MeetDeore19/soc_estimator/calce_plots/calce_A1-008_ocv.png

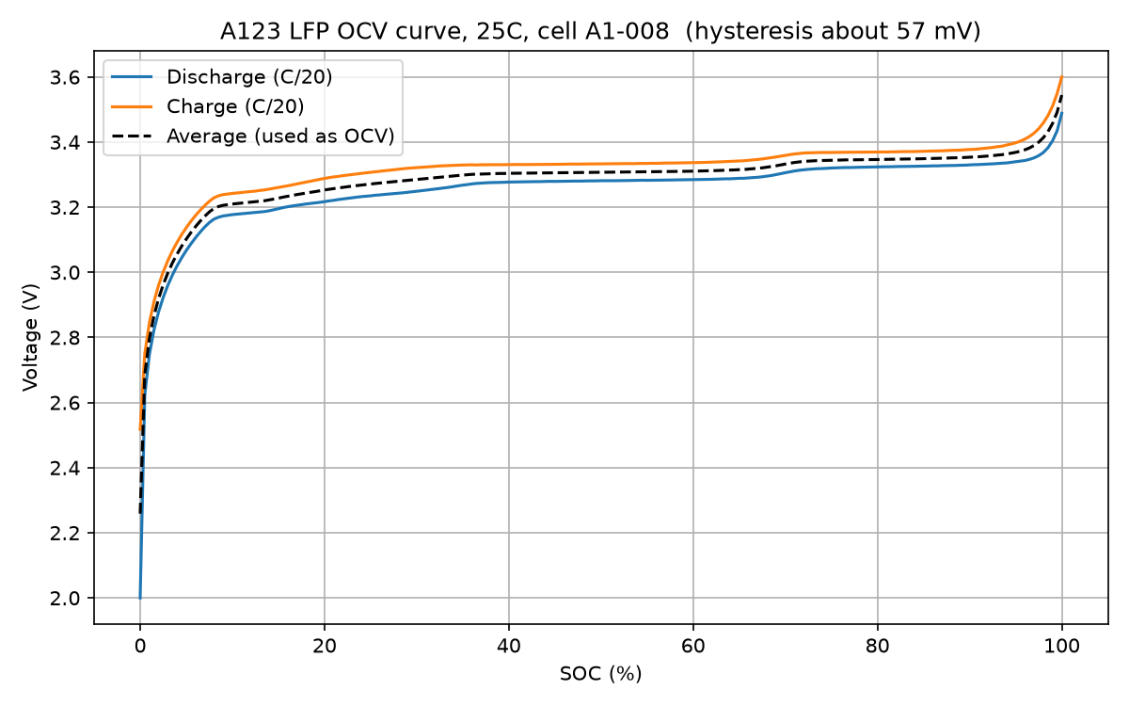
calce_plots/calce_A1-008_ocv.png
