MeetDeore19/soc_estimator/data/20261102_163730_validation_v2.csv

pc_time | esp_ms | c1_v | c2_v | c3_v | c4_v | pack_v | current_a | temp1_c | temp2_c | counted_ah
2026-11-02T16:37:31 | 5591512 | 3.4388 | 3.3575 | 3.4020 | 3.5523 | 13.7506 | 0.0021 | -30.82 | -27.12 | 0.000000
2026-11-02T16:37:32 | 5592512 | 3.4373 | 3.3581 | 3.4022 | 3.5513 | 13.7489 | -0.0026 | -29.41 | -24.45 | -0.000001
2026-11-02T16:37:33 | 5593512 | 3.4389 | 3.3589 | 3.4001 | 3.5525 | 13.7504 | -0.0019 | -28.74 | -24.00 | -0.000001
2026-11-02T16:37:34 | 5594512 | 3.4373 | 3.3603 | 3.4003 | 3.5518 | 13.7497 | -0.0003 | -29.31 | -21.28 | -0.000001
2026-11-02T16:37:35 | 5595512 | 3.4379 | 3.3585 | 3.4016 | 3.5526 | 13.7506 | -0.0016 | -30.00 | -23.27 | -0.000002
2026-11-02T16:37:36 | 5596512 | 3.4392 | 3.3606 | 3.3980 | 3.5540 | 13.7518 | -0.0047 | -30.30 | -23.27 | -0.000003
2026-11-02T16:37:37 | 5597512 | 3.4396 | 3.3591 | 3.4001 | 3.5570 | 13.7558 | -0.0074 | -33.51 | -25.78 | -0.000005
2026-11-02T16:37:38 | 5598512 | 3.4374 | 3.3595 | 3.4012 | 3.5528 | 13.7509 | -0.0016 | -34.00 | -25.78 | -0.000006
2026-11-02T16:37:39 | 5599512 | 3.4378 | 3.3583 | 3.4010 | 3.5543 | 13.7514 | 0.0036 | -34.00 | -24.30 | -0.000005
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
