MeetDeore19/soc_estimator/data/20261102_163730_validation_v2_soc.csv

pc_time | esp_ms | c1_v | c2_v | c3_v | c4_v | pack_v | current_a | temp1_c | temp2_c | counted_ah | t | avg_cell | soc_ekf | soc_sigma | v_pred | offset_learned | soc_gain | soc_coulomb_only | soc_reference
2026-11-02T16:37:31 | 5591512 | 3.4388 | 3.3575 | 3.402 | 3.5523 | 13.7506 | 0.0021 | -30.82 | -27.12 | 0.0 | 0.0 | 3.4376499999999997 | 1.0 | 0.017440836210075736 | 3.37996514 | 0.0 | 2.7859140618934735 | 1.0 | 1.0
2026-11-02T16:37:32 | 5592512 | 3.4373 | 3.3581 | 3.4022 | 3.5513 | 13.7489 | -0.0026 | -29.41 | -24.45 | -1e-06 | 1.0 | 3.4372249999999998 | 1.0 | 0.01273619759030887 | 3.3801336282655576 | 0.0 | 1.414485386659199 | 0.9999999041547545 | 0.9999997717970345
2026-11-02T16:37:33 | 5593512 | 3.4389 | 3.3589 | 3.4001 | 3.5525 | 13.7504 | -0.0019 | -28.74 | -24.0 | -1e-06 | 2.0 | 3.4376 | 1.0 | 0.010668366091758296 | 3.3801450447141965 | 0.0 | 0.9490833186706709 | 1.0 | 0.9999996348752551
2026-11-02T16:37:34 | 5594512 | 3.4373 | 3.3603 | 3.4003 | 3.5518 | 13.7497 | -0.0003 | -29.31 | -21.28 | -1e-06 | 3.0 | 3.437425 | 1.0 | 0.009451613462216353 | 3.3801066930032295 | 0.0 | 0.7151424545967794 | 1.0 | 0.9999994454667938
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
