MeetDeore19/soc_estimator/data/experiments/20261021_171919_zero_offset.csv

pc_time | esp_ms | c1_v | c2_v | c3_v | c4_v | pack_v | current_a | temp1_c | temp2_c | counted_ah
2026-10-21T17:19:19 | 621080 | 3.2896 | 3.2803 | 3.2881 | 3.2912 | 13.1492 | -0.0283 | 24.24 | 12.35 | 0.000000
2026-10-21T17:19:20 | 622080 | 3.2896 | 3.2867 | 3.2818 | 3.2912 | 13.1493 | -0.0114 | 24.29 | 11.88 | -0.000003
2026-10-21T17:19:21 | 623080 | 3.2896 | 3.2867 | 3.2818 | 3.3037 | 13.1618 | -0.0121 | 24.29 | 11.42 | -0.000007
2026-10-21T17:19:22 | 624080 | 3.2772 | 3.2928 | 3.2881 | 3.2912 | 13.1493 | -0.0223 | 24.29 | 12.59 | -0.000013
2026-10-21T17:19:23 | 625080 | 3.2896 | 3.2803 | 3.2881 | 3.3037 | 13.1617 | -0.0119 | 24.29 | 13.35 | -0.000016
2026-10-21T17:19:24 | 626080 | 3.2896 | 3.2867 | 3.2818 | 3.2912 | 13.1493 | -0.0173 | 24.29 | 14.29 | -0.000021
2026-10-21T17:19:25 | 627080 | 3.3021 | 3.2742 | 3.2818 | 3.2912 | 13.1493 | -0.0251 | 24.29 | 14.13 | -0.000028
