MeetDeore19/soc_estimator/data/experiments/20261021_171931_zero_offset.csv

pc_time | esp_ms | c1_v | c2_v | c3_v | c4_v | pack_v | current_a | temp1_c | temp2_c | counted_ah
2026-10-21T17:19:31 | 633080 | 3.3021 | 3.2742 | 3.2818 | 3.3037 | 13.1618 | -0.0060 | 24.29 | 8.47 | 0.000000
2026-10-21T17:19:32 | 634080 | 3.3021 | 3.2742 | 3.2818 | 3.3037 | 13.1618 | -0.0165 | 24.29 | 8.44 | -0.000005
2026-10-21T17:19:33 | 635080 | 3.3021 | 3.2742 | 3.2880 | 3.2976 | 13.1619 | -0.0165 | 24.29 | 9.57 | -0.000009
2026-10-21T17:19:34 | 636080 | 3.3021 | 3.2742 | 3.2818 | 3.2912 | 13.1493 | -0.0362 | 24.29 | 8.58 | -0.000019
2026-10-21T17:19:35 | 637080 | 3.3021 | 3.2742 | 3.2818 | 3.2849 | 13.1430 | -0.0154 | 24.29 | 8.78 | -0.000024
2026-10-21T17:19:36 | 638080 | 3.3021 | 3.2742 | 3.2818 | 3.3037 | 13.1618 | -0.0139 | 24.29 | 7.65 | -0.000027
2026-10-21T17:19:37 | 639080 | 3.2896 | 3.2867 | 3.2818 | 3.2912 | 13.1493 | -0.0199 | 24.29 | 14.78 | -0.000033
2026-10-21T17:19:38 | 640080 | 3.2896 | 3.2867 | 3.2818 | 3.2912 | 13.1493 | -0.0205 | 24.29 | 15.32 | -0.000039
2026-10-21T17:19:39 | 641080 | 3.3021 | 3.2742 | 3.2818 | 3.3037 | 13.1618 | -0.0166 | 24.29 | 15.15 | -0.000043
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
