MeetDeore19/soc_estimator/data/20261102_163730_validation_v2_soc_plot.png

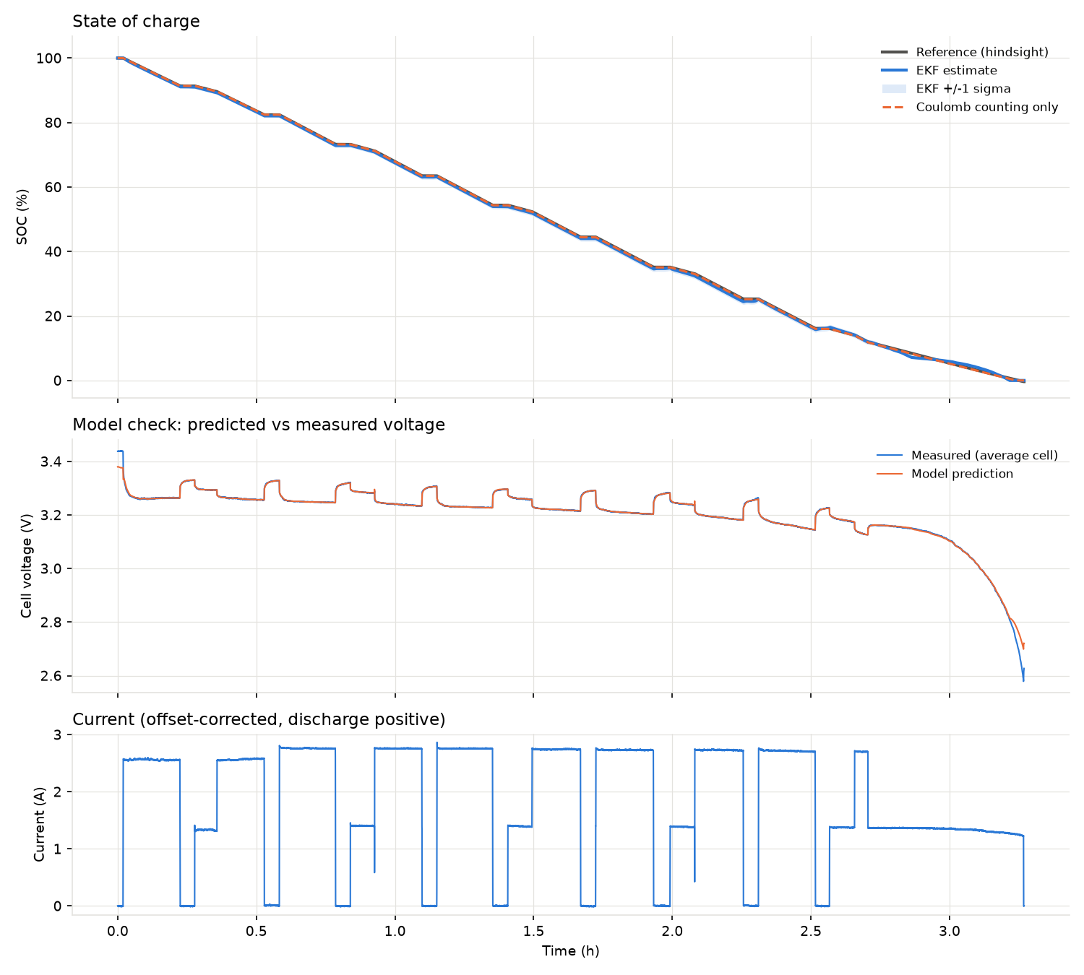
data/20261102_163730_validation_v2_soc_plot.png
