MeetDeore19/soc_estimator/data/experiments/noise_tests/noise_test_caps_soc_plot.png

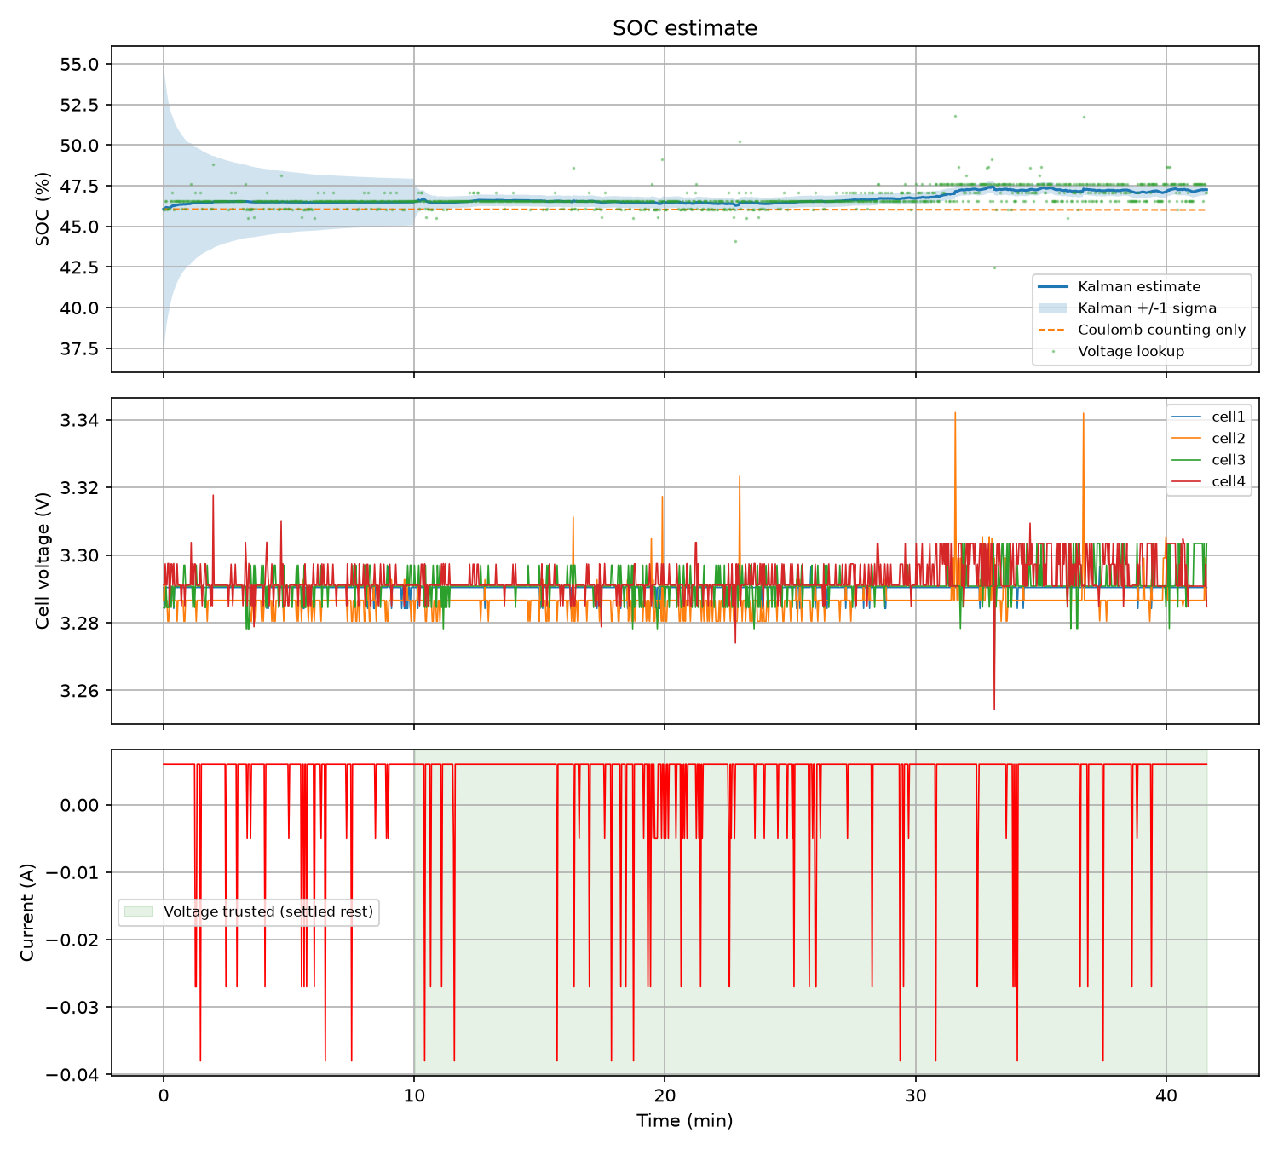
data/experiments/noise_tests/noise_test_caps_soc_plot.png
