MeetDeore19/soc_estimator/data/experiments/noise_tests/noise_test_lowpower_plot.png

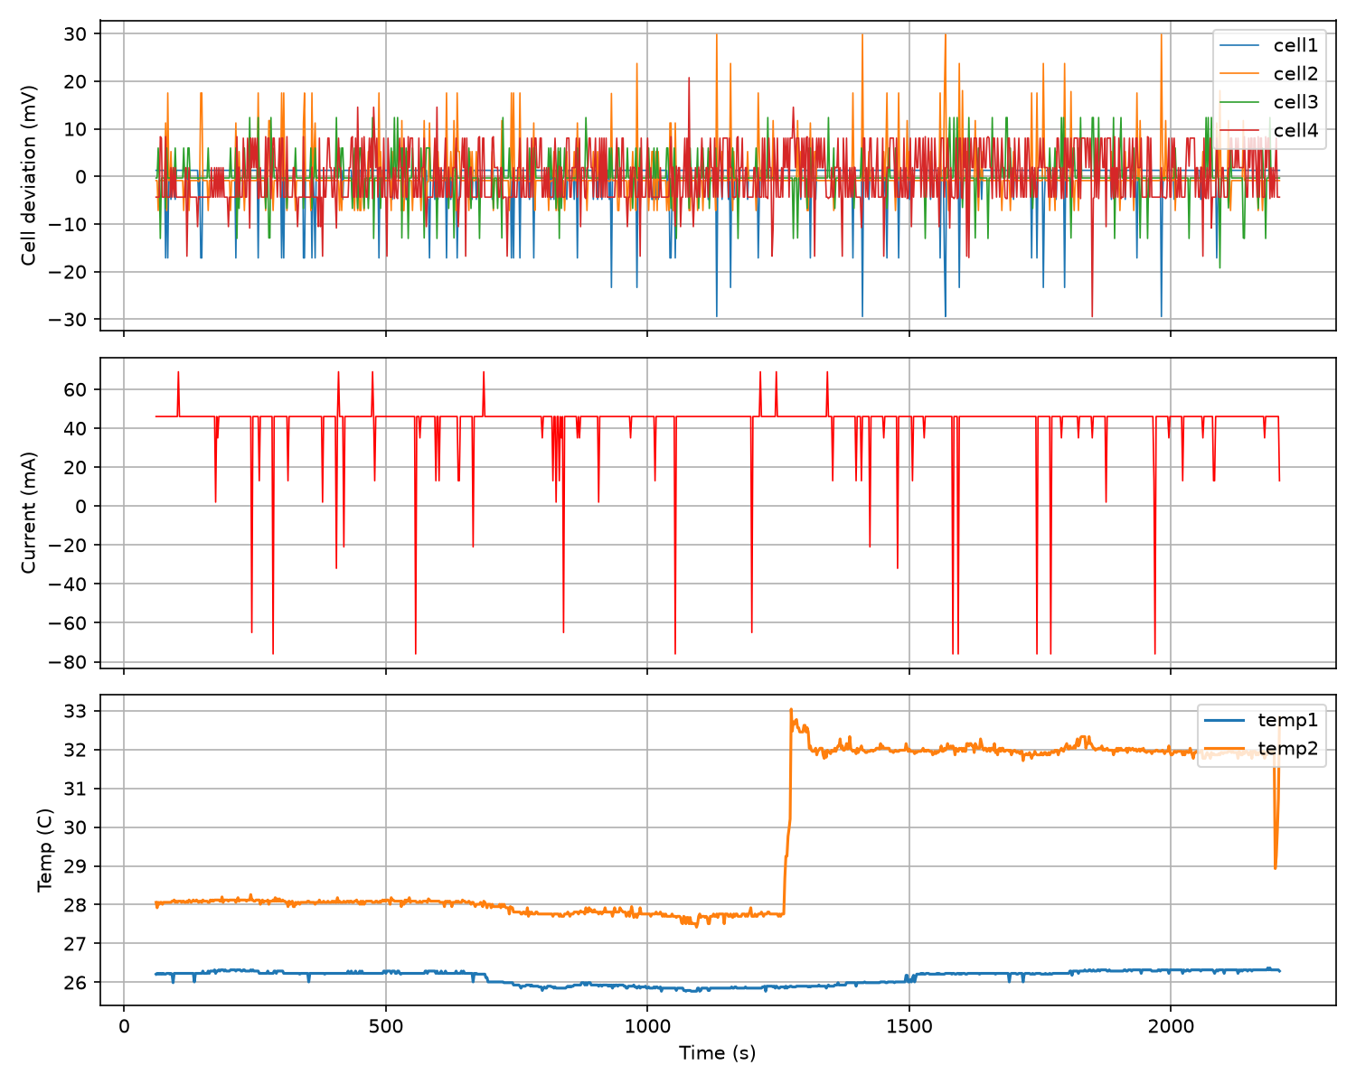
data/experiments/noise_tests/noise_test_lowpower_plot.png
