MeetDeore19/soc_estimator/results/pulse_test_overview.png

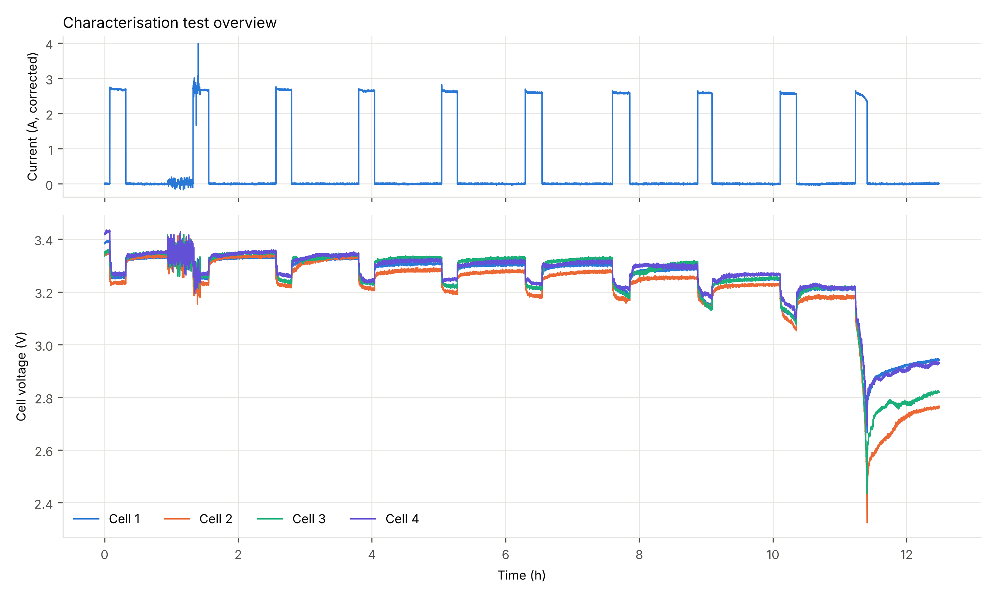
results/pulse_test_overview.png
