MeetDeore19/soc_estimator/results/r0_vs_soc.png

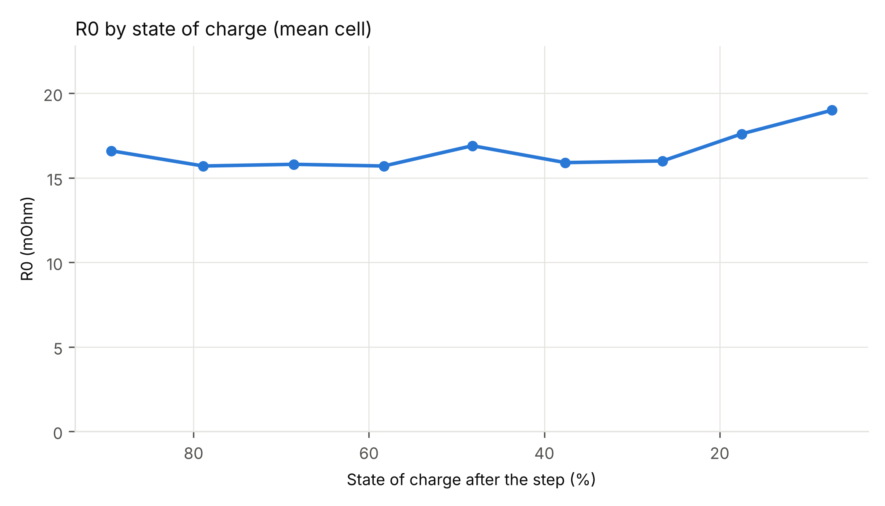
results/r0_vs_soc.png
