MeetDeore19/soc_estimator/results/relaxation_fit_1rc_vs_2rc.png

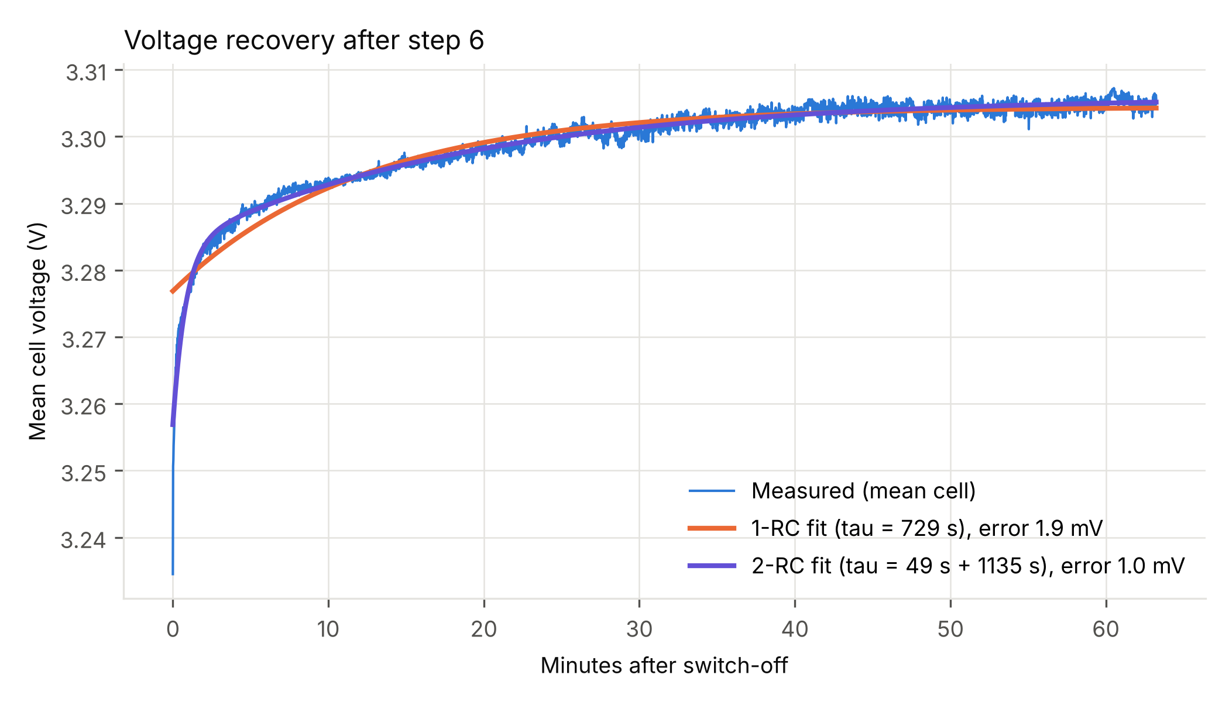
results/relaxation_fit_1rc_vs_2rc.png
